kleinher/Taller-de-Proyecto-firmware/README.md

# Control de Iluminación

Proyecto "Sistema Centralizado de Control de Iluminación de un Ambiente".

Basado en plataforma EDU-CIAA-NXP.

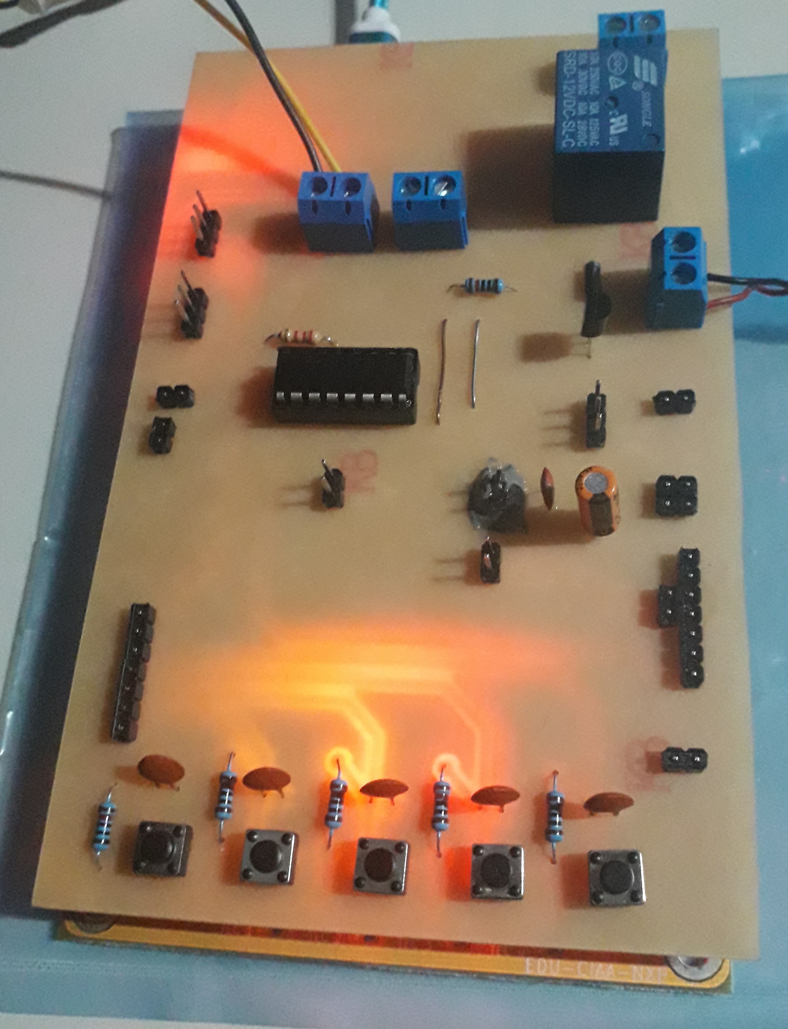
[picture p1: poncho-sin-wifi.jpg]


El repositorio contiene:
- Código fuente EDU-CIAA (firmware).
- Esquemático, diseño PCB y archivos del software Proteus
- Lista de materiales, actualizada al 22/02/2023
- Documentación consultada (disponible digitalmente): normas, manuales, hojas de datos
- Informe en formato PDF detallando el desarrollo del proyecto (versión final, 22/02/2023)
