kleinher/Taller-de-Proyecto-firmware/proteus/README.md

## /proteus/

Archivos de Proteus: esquemáticos, PCBs y librerías de componentes
