kleinher/Taller-de-Proyecto-firmware/proteus/librerias/README.md

## /proteus/librerias/

Librerías adicionales a Proteus.

Instalar en <Directorio de Proteus>/Data/MCAD.
