kleinher/Taller-de-Proyecto-firmware/proteus/v2-feb23/README.md

## /proteus/v2-feb23 

Versión final del poncho. Se corrigió el diseño en base a los problemas experimentados durante la fabricación en el ATEI.
