kleinher/Taller-de-Proyecto-firmware/proteus/test/README.md

## /proteus/test

Archivos sobre la placa de pruebas del poncho.

Es una placa que se hizo para probar el funcionamiento del programa antes de fabricar el PCB del poncho.

Se armó sobre una placa de circuito universal de 10x5cm.
