kleinher/Taller-de-Proyecto-firmware/proteus/v1-dec22/sch.pdf

# 9.2. Circuito Esquemático Completo

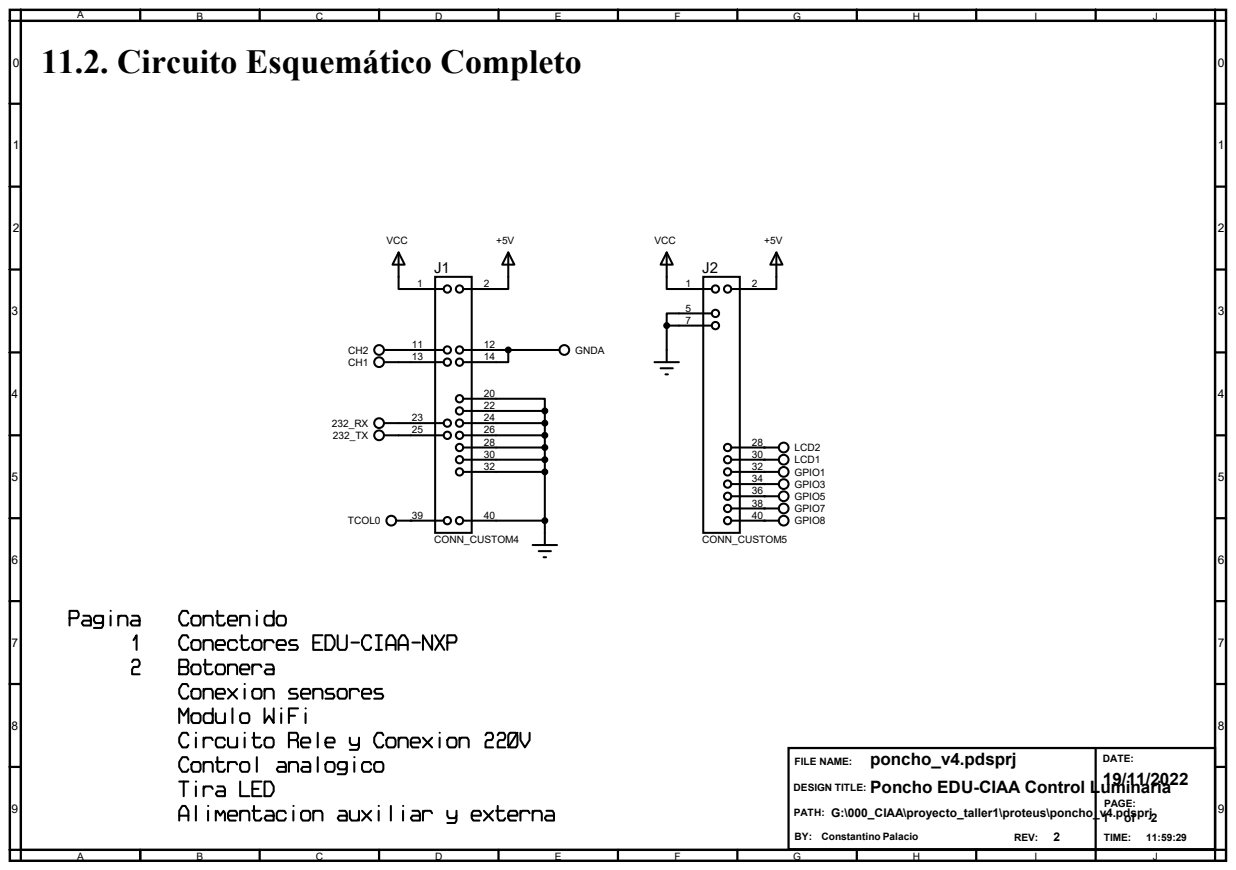
[picture p35: page 1]
DATE:; PAGE:; poncho_v4.pdsprj; Constantino Palacio; REV:; TIME:; VCC; GNDA; TCOL0; CONN_CUSTOM4; CONN_CUSTOM5; LCD2 LCD1 GPIO1 GPIO3 GPIO5 GPIO7 GPIO8

FILE NAME:
DESIGN TITLE: Poncho EDU-CIAA Control Luminaria

PATH: G:\000_CIAA\proyecto_taller1\proteus\poncho_v4.pdsprj 1 of 2

RL1

Q1

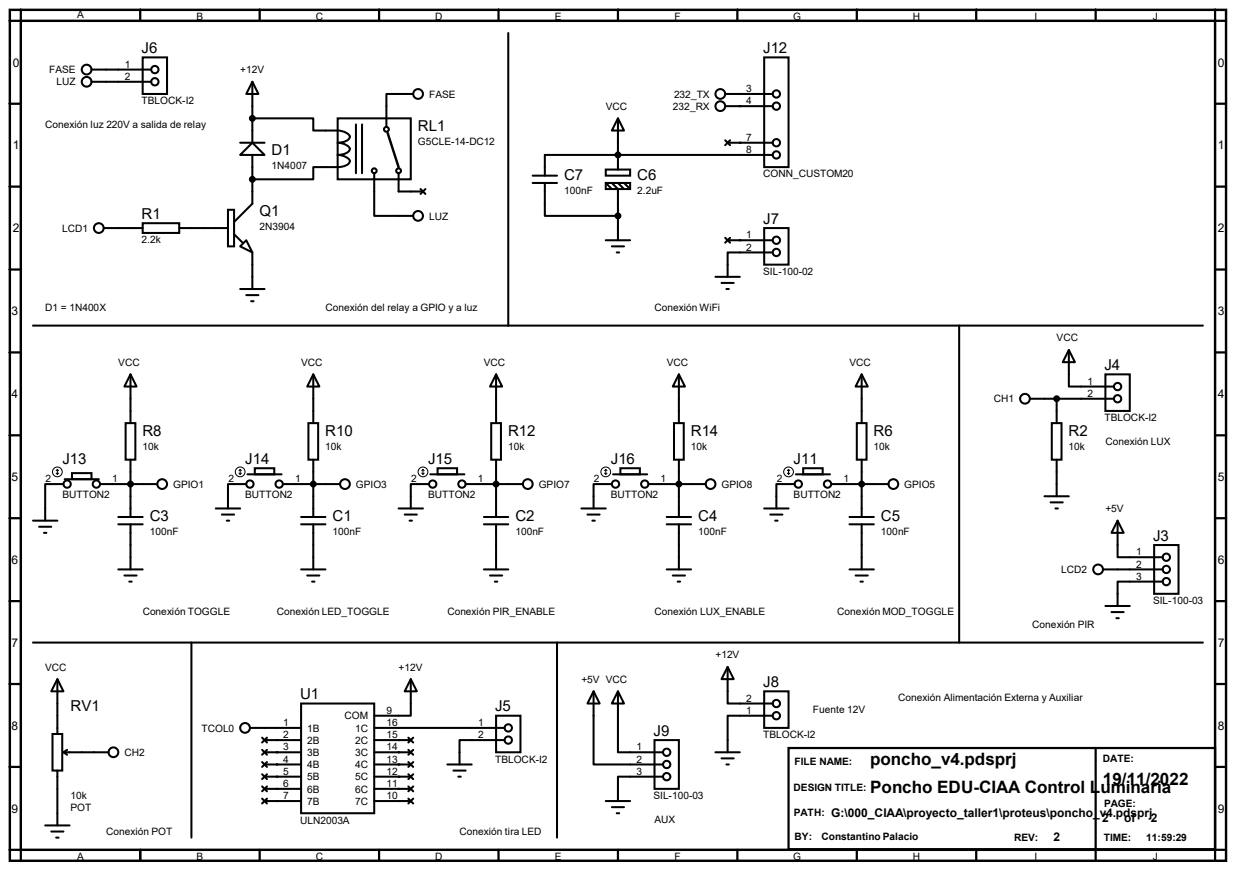
[picture p36: page 2]

Conexión luz 220V a salida de relay

Conexión del relay a GPIO y a luz

Conexión Alimentación Externa y Auxiliar

FILE NAME:
DESIGN TITLE: Poncho EDU-CIAA Control Luminaria

PATH: G:\000_CIAA\proyecto_taller1\proteus\poncho_v4.pdsprj 2 of 2
