kleinher/Taller-de-Proyecto-firmware/proteus/v2-feb23/sch.PDF

# 11.2. Circuito Esquemático Completo

A continuación se reproduce el esquemático del poncho. El mismo se divide en secciones según la función que cumpla en el circuito.

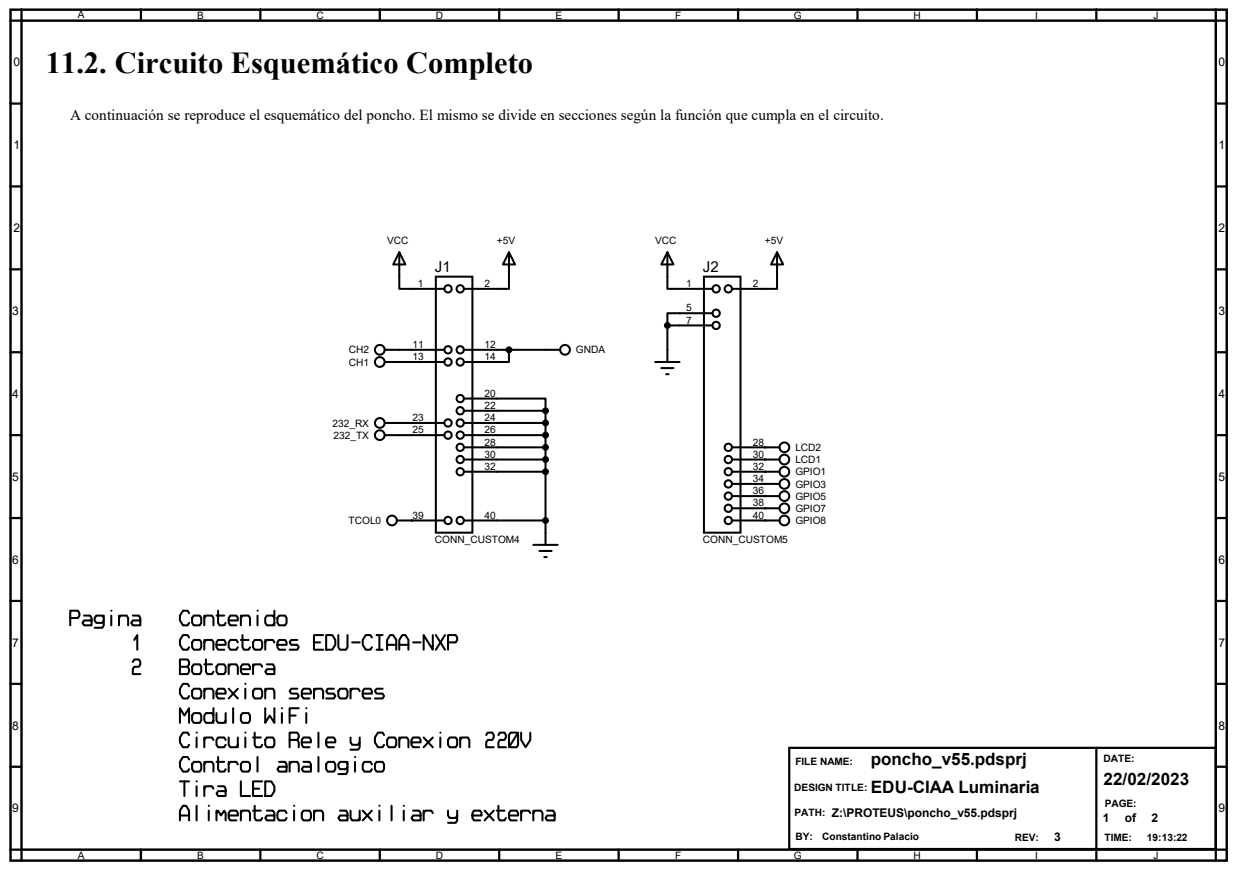
[picture p37: page 1]
DATE:; PAGE:; poncho_v55.pdsprj; Constantino Palacio; PATH: Z:\PROTEUS\poncho_v55.pdsprj; REV:; TIME:; VCC; GNDA; TCOL0; CONN_CUSTOM4; CONN_CUSTOM5; LCD2 LCD1 GPIO1 GPIO3 GPIO5 GPIO7 GPIO8

FILE NAME:
DESIGN TITLE: EDU-CIAA Luminaria

RL1

J6

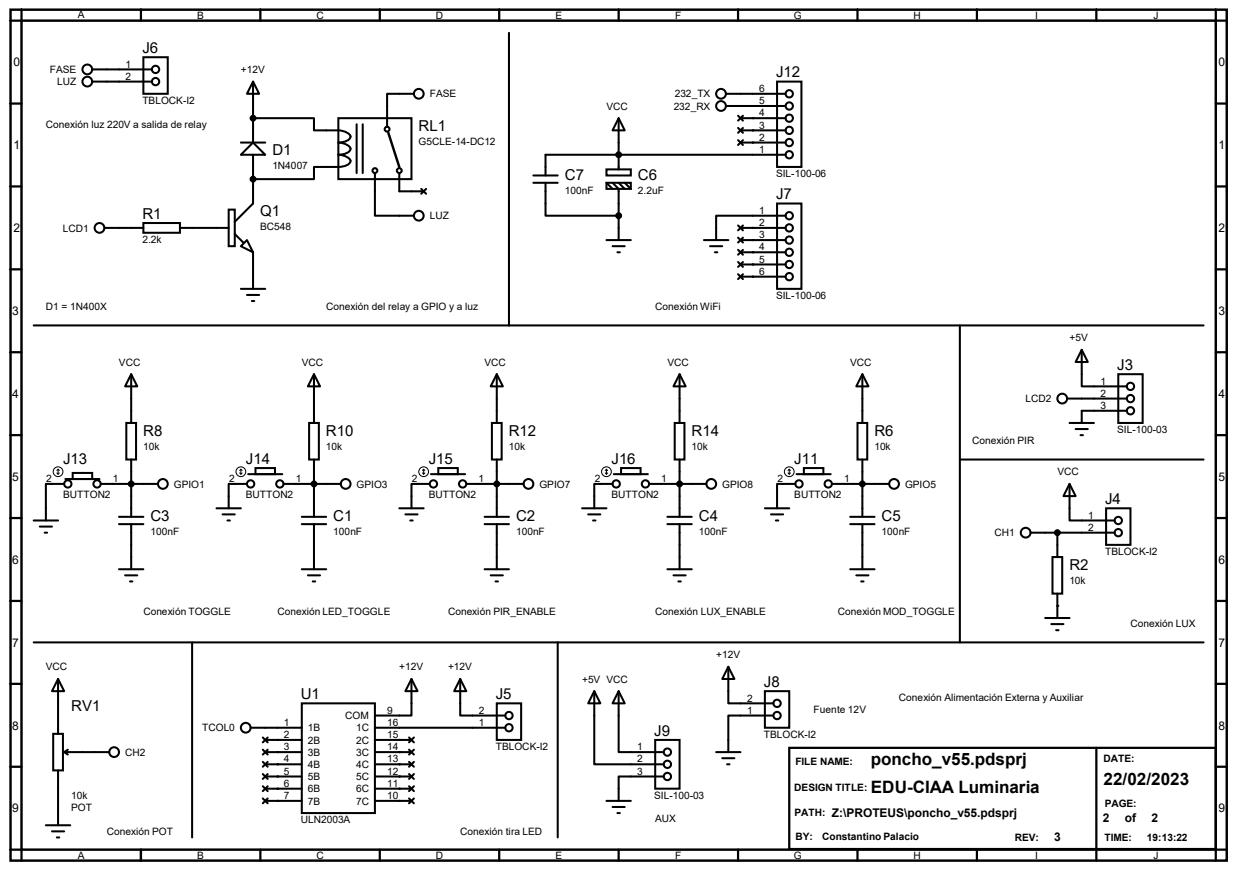
[picture p38: page 2]

Conexión luz 220V a salida de relay

Conexión del relay a GPIO y a luz

Conexión Alimentación Externa y Auxiliar

FILE NAME:
DESIGN TITLE: EDU-CIAA Luminaria
