kleinher/Taller-de-Proyecto-firmware/proteus/v1-dec22/bom.pdf

# Bill Of Materials for Poncho EDU-CIAA Control Luminaria

Design Title | Poncho EDU-CIAA Control Luminaria
Author | Constantino Palacio
Document Number | 1
Revision | 2
Design Created | viernes, 11 de noviembre de 2022
Design Last Modified sábado, 19 de noviembre de 2022

## Total Parts In Design 34

## 7Capacitors

Quantity | References | Value | Unit Cost
6 | C1-C5,C7 | 100nF | $10,00
1 | C6 | 2.2uF | $10,00
Sub-totals: | | | $70,00

## 7Resistors

Quantity | References | Value | Unit Cost
1 | R1 | 2.2k | $5,00
6 | R2,R6,R8,R10,R12,R14 | 10k | $5,00
Sub-totals: | | | $35,00

## 1Integrated Circuits

Quantity | References | Value | Unit Cost
1 | U1 | ULN2003A
Sub-totals: | | | $0,00

## 1Transistors

Quantity | References | Value | Unit Cost
1 | Q1 | 2N3904 | $25,00
Sub-totals: | | | $25,00

## 1Diodes

Quantity | References | Value | Unit Cost
1 | D1 | 1N4007
Sub-totals: | | | $0,00

## 17Miscellaneous

Quantity | References | Value | Unit Cost
1 | J1 | CONN_CUSTOM4
1 | J2 | CONN_CUSTOM5

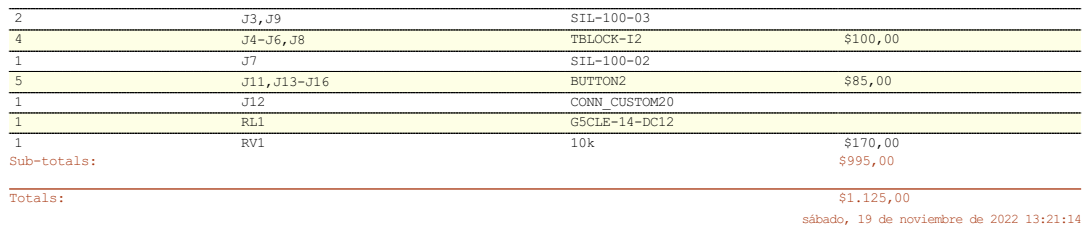
[picture p39: page 2]
