kleinher/Taller-de-Proyecto-firmware/proteus/v1-dec22/pcb.pdf

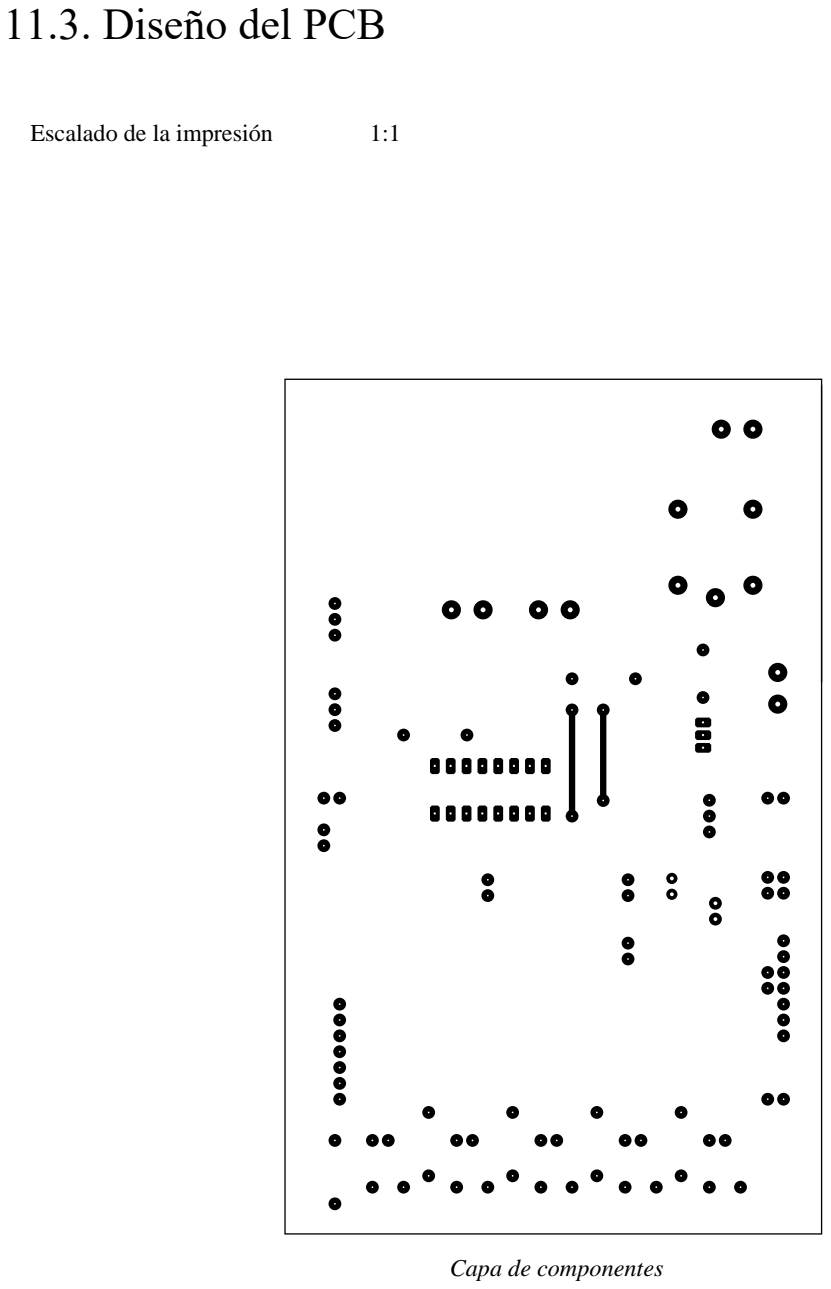
[picture p40: page 1]

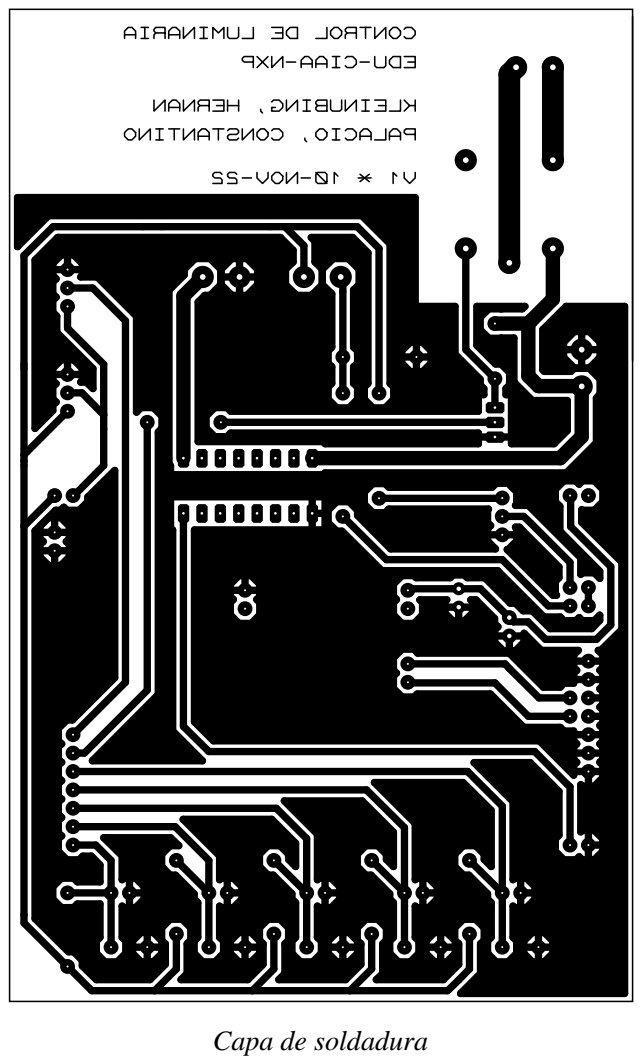
[picture p41: page 2]

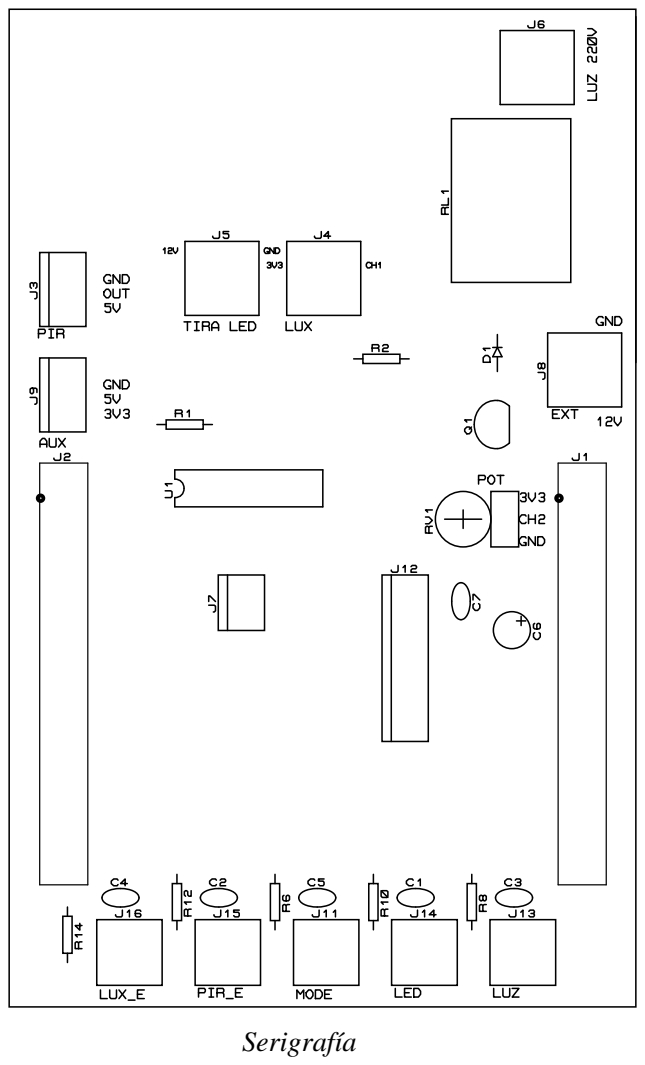
[picture p42: page 3]
