kleinher/Taller-de-Proyecto-firmware/proteus/v2-feb23/pcb.PDF

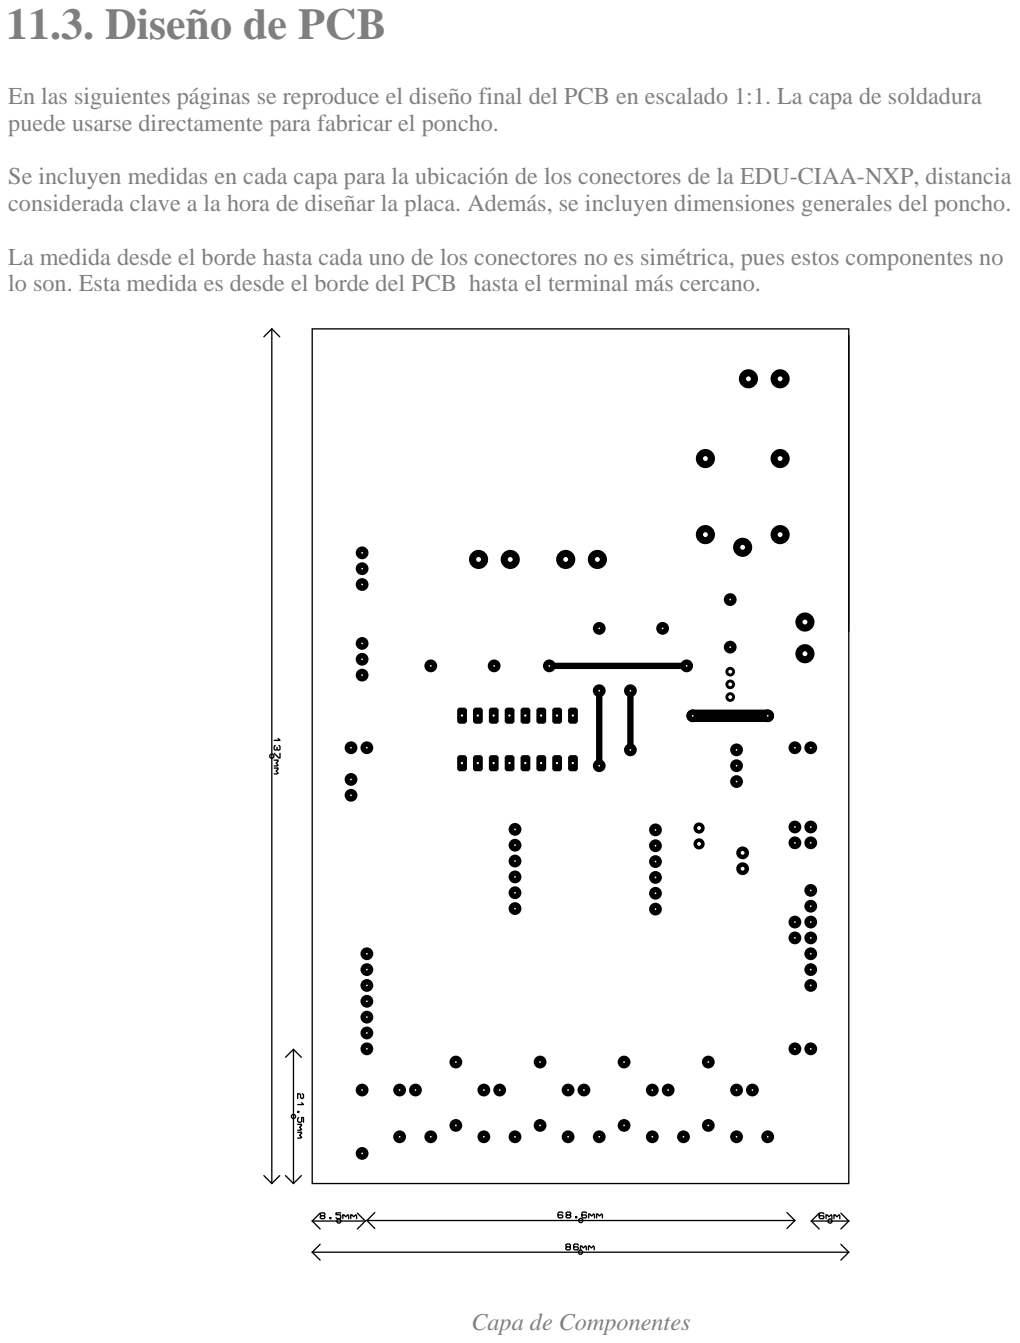
[picture p43: page 1]

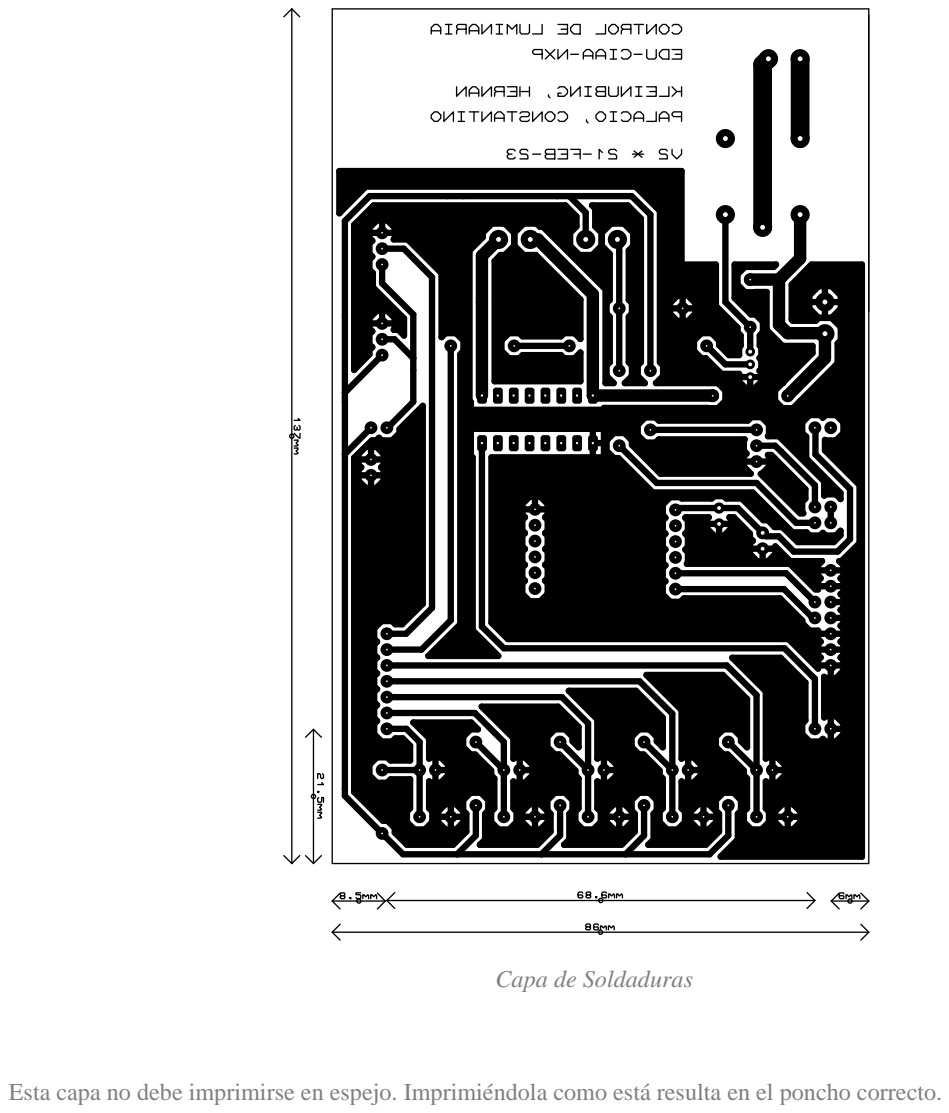
[picture p44: page 2]

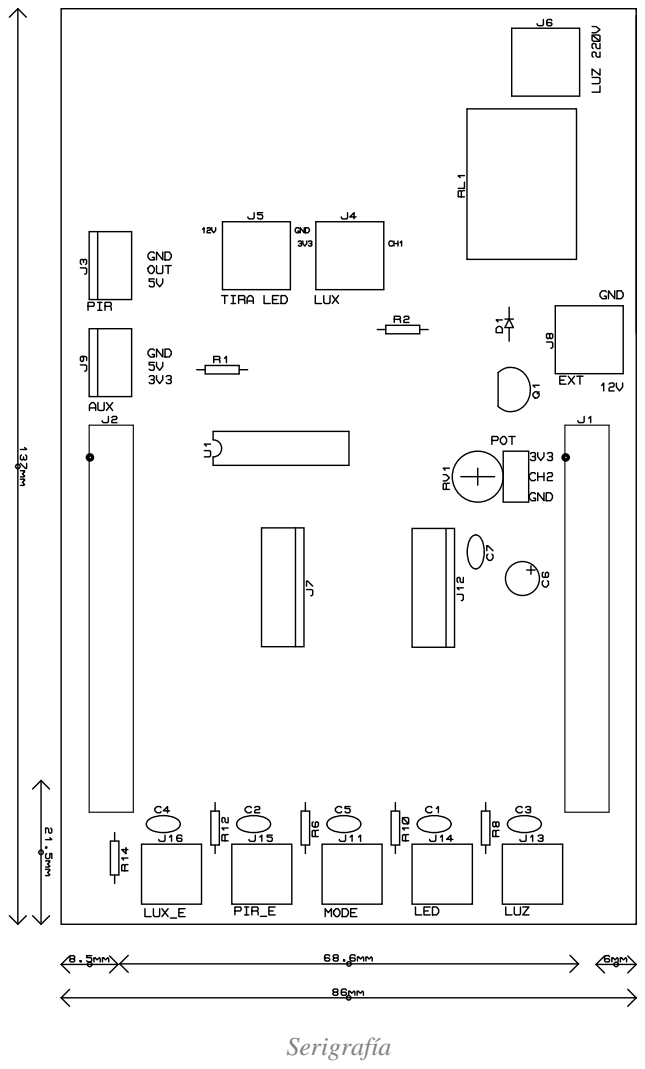
[picture p45: page 3]
