kleinher/Taller-de-Proyecto-firmware/proteus/v1-dec22/view.pdf

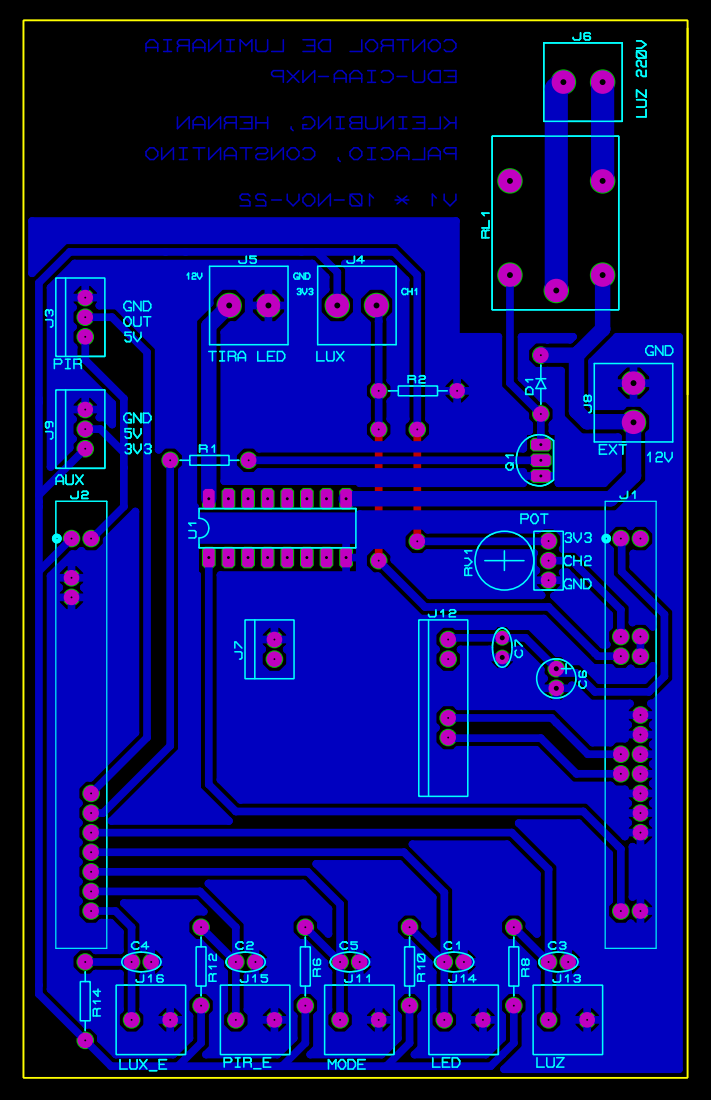
[picture p46: page 1]
