kleinher/Taller-de-Proyecto-firmware/(list of files, drawings)

Other design files:
proteus/v1-dec22/poncho_v1.pdsprj
proteus/v2-feb23/poncho_v2.pdsprj
