kleinher/Taller-de-Proyecto-firmware/main/src/pir.c

/*
   CONTROL SENSOR DE MOVIMIENTO HC-S501 (PIR)
   
   CONSTANTINO PALACIO, OCT-22.
*/

#include "sapi.h"
#include "pir.h"
#include "puertos.h"

int   pir_status = OFF,       // inicialmente, el PIR está desactivado
      pir_value;              // valor leído desde el PIR

void pir_off() {
   pir_status=OFF;                     // apagar PIR
   gpioWrite(PIR_ST_OUT, OFF);         // y actualizar el LED de estado
}

void pir_on() {
   pir_status=ON;                      // encender PIR
   gpioWrite(PIR_ST_OUT, ON);          // y actualizar el LED de estado
}

void pir_toggle() {
   if (!gpioRead(PIR_ENABLE)) {
      delay(10);
      if (!gpioRead(PIR_ENABLE))
         pir_status=!pir_status;
   }
   if(pir_status) pir_on();
   else pir_off();
   //printf("* PIR    %d *\n",pir_status);
}

int pir_enabled() {
   return pir_status;
}

/*
   Funcion PIR_READ
      RECIBE   NADA
      RETORNA  0: NO HAY MOVIMIENTO (O DESHABILITADO), 1: HAY MOVIMIENTO

   Lee el puerto del sensor PIR y devuelve si hay o no movimiento siempre y cuando esté habilitado el sensor.
*/

int pir_read() {
   
   int estado=!gpioRead(PIR_IN);
   delay(50);
   estado=gpioRead(PIR_IN);
   
 
   if (pir_status){ 
      if(estado){
         gpioInit(GPIO0, GPIO_OUTPUT);
         gpioWrite(GPIO0, ON); return estado;  
      }
      else{
         gpioWrite(GPIO0, OFF); 
      }
   } else {
      gpioWrite(GPIO0, OFF);
      return 0;
      }
}
