kleinher/Taller-de-Proyecto-firmware/main/inc/luces.h

#ifndef LUCES_H_
#define LUCES_H_

void relay_on();
void relay_off();
void relay_toggle();
int relay_change();
void led_bright(int b);
int toggle_read();
int pot_read();
void led_toggle();
void led_on();
void led_off();
#endif
