kleinher/Taller-de-Proyecto-firmware/(commit log)

2022-10-03 Carga de archivos de Embedded IDE
    [app.names.csv, lpc4337.cfg, main.names.csv]
2022-10-03 Ejemplos Arduino, datasheets, proteus
    [poncho [20220929, 10-32-38].pdsprj, poncho [20220929, 10-33-02].pdsprj, poncho [20220929, 21-21-49].pdsprj, poncho [20220929, 21-44-48].pdsprj, poncho [20220929, 21-45-22].pdsprj, poncho [20220930, 20-53-06].pdsprj, poncho [20220930, 20-53-44].pdsprj, poncho.pdsprj]
2022-10-04 Esquemático Proteus
    [poncho [20221003, 20-40-00].pdsprj, poncho [20221003, 21-17-37].pdsprj, poncho.pdsprj]
2022-10-08 Actualización 08/10/2022
    [main.names.csv, poncho [20220929, 10-32-38].pdsprj, poncho [20221006, 13-24-49].pdsprj, poncho [20221006, 13-27-41].pdsprj, poncho.pdsprj]
2022-10-09 Actualización 09/10/2022
    [main.names.csv, poncho [20220929, 10-33-02].pdsprj, poncho [20220929, 21-21-49].pdsprj, poncho [20220929, 21-44-48].pdsprj, poncho [20220929, 21-45-22].pdsprj, poncho [20220930, 20-53-06].pdsprj, poncho [20220930, 20-53-44].pdsprj, poncho [20221003, 20-40-00].pdsprj]
2022-10-13 Corrección, test, datasheets, esquemático
    [main.names.csv]
2022-10-16 Actualización 16/10/2022
    [main.names.csv, poncho [20221008, 17-43-02].pdsprj, poncho [20221008, 18-02-59].pdsprj, poncho [20221008, 18-05-30].pdsprj, poncho [20221008, 18-06-17].pdsprj, poncho [20221008, 18-06-30].pdsprj, poncho [20221008, 18-26-08].pdsprj, poncho [20221008, 18-50-28].pdsprj]
2022-10-17 Actualización 16/10/2022 (2)
    [poncho [20221016, 12-15-02].pdsprj, poncho [20221016, 12-19-25].pdsprj, poncho [20221016, 21-09-04].pdsprj, poncho [20221016, 23-27-56].pdsprj, poncho.pdsprj]
2022-10-18 Corrección, datasheets, esquemático
    [poncho [20221016, 12-21-54].pdsprj, poncho [20221016, 12-22-32].pdsprj, poncho [20221016, 12-42-43].pdsprj, poncho [20221017, 11-05-15].pdsprj, poncho [20221017, 11-05-28].pdsprj, poncho [20221017, 11-24-02].pdsprj, poncho.pdsprj]
2022-10-31 Código LUX, PCB test
    [poncho [20221016, 13-31-07].pdsprj, poncho [20221016, 14-48-10].pdsprj, poncho [20221016, 14-50-07].pdsprj, poncho [20221027, 15-37-28].pdsprj, poncho [20221028, 18-10-41].pdsprj, poncho [20221029, 10-40-21].pdsprj, poncho.pdsprj, poncho_placa_test [20221028, 20-27-58].pdsprj]
2022-11-06 Corrección PCB test, diseño preliminar poncho
    [poncho [20221016, 14-54-05].pdsprj, poncho [20221016, 19-37-37].pdsprj, poncho [20221016, 21-09-04].pdsprj, poncho [20221016, 23-27-56].pdsprj, poncho [20221017, 11-05-15].pdsprj, poncho [20221017, 11-05-28].pdsprj, poncho [20221017, 11-24-02].pdsprj, poncho [20221027, 15-37-28].pdsprj]
2022-11-07 Diseño PCB, código test, placa
    [main.names.csv, poncho [20221103, 20-37-26].pdsprj, poncho [20221103, 20-44-05].pdsprj, poncho [20221103, 21-08-39].pdsprj, poncho [20221103, 21-29-19].pdsprj, poncho [20221103, 21-31-40].pdsprj, poncho [20221103, 21-55-21].pdsprj, poncho [20221103, 22-22-00].pdsprj]
2022-11-13 Poncho, código PWM, actualización puertos
    [main.names.csv, poncho_ground_plane [20221107, 11-05-08].pdsprj, poncho_ground_plane [20221107, 11-05-35].pdsprj, poncho_ground_plane [20221107, 11-58-11].pdsprj, poncho_ground_plane [20221111, 13-47-29].pdsprj, poncho_ground_plane [20221111, 14-10-50].pdsprj, poncho_ground_plane [20221111, 17-28-27].pdsprj, poncho_ground_plane [20221111, 17-30-58].pdsprj]
2022-11-24 Corrección PCB
    [poncho_v4 [20221111, 17-43-09].pdsprj, poncho_v4 [20221111, 17-58-26].pdsprj, poncho_v4 [20221117, 11-24-30].pdsprj, poncho_v4 [20221117, 22-51-03].pdsprj, poncho_v4 [20221117, 22-51-24].pdsprj, poncho_v4 [20221118, 19-41-54].pdsprj, poncho_v4 [20221119, 10-34-17].pdsprj, poncho_v4 [20221119, 10-43-00].pdsprj]
2022-11-27 Merge Lux
    Mergeados los cambios de lux
2022-11-27 Funcionando
    Funcionando con botones y leds de la CIAA
2022-11-27 Funcionando
    Agregada funcionamiento de prender luz
2022-12-19 Funcionando
    Horrible pero anda
    [main.names.csv]
2023-02-07 Potenciometro
    Mejorado el código del potenciometro manual
2023-02-23 Limpieza, Informe Final
    [poncho [20221106, 22-37-45].pdsprj, poncho [20221106, 22-41-33].pdsprj, poncho [20221106, 22-48-44].pdsprj, poncho [20221106, 23-01-00].pdsprj, poncho [20221106, 23-01-17].pdsprj, poncho [20221107, 00-31-49].pdsprj, poncho [20221107, 00-35-35].pdsprj, poncho [20221107, 00-46-25].pdsprj]
2023-02-23 Archivo de Proteus v2
    [poncho_v2.pdsprj]
